markditsworth/Solar/README.md

# Solar

#### 300 Watt Solar Bank with Battery Storage
