markditsworth/Solar/inverter/Sims/boost.asc

C1: polcap; 3300µ; V=63 Irms=2.27 Rser=0.0218909 Lser=34.4602n mfg="Würth Elektronik" pn="861140784012 WCAP-AI3H 25x35" type="Al electrolytic"
C2: cap; 2.3n; V=100
C3: cap; 0.1
C5: polcap; 3300µ; V=63 Irms=2.27 Rser=0.0218909 Lser=34.4602n mfg="Würth Elektronik" pn="861140784012 WCAP-AI3H 25x35" type="Al electrolytic"
D1: schottky; MBRS1100
L1: ind; 1000n; Ipk=63 Rser=0.0016 Rpar=94.2 Cpar=0 mfg="Coilcraft" pn="CU8838"
M1: nmos; BSC016N03MS
R1: res; 1; pwr=500
R2: res; 580K; pwr=500
R3: res; 100K; pwr=500
R4: res; 6; pwr=500
R5: res; 2600; pwr=0.25
R6: res; 0.0075; pwr=500
U1: LT1241
V1: voltage; 12
V2: voltage; 15
Named nets: 0, Out, bridge, GS, 15V
.tran 0.01u 1m 0
