markditsworth/Solar/charger/charger.kicad_pcb

## KiCad design charger/charger.kicad_pcb (2020-12-03)

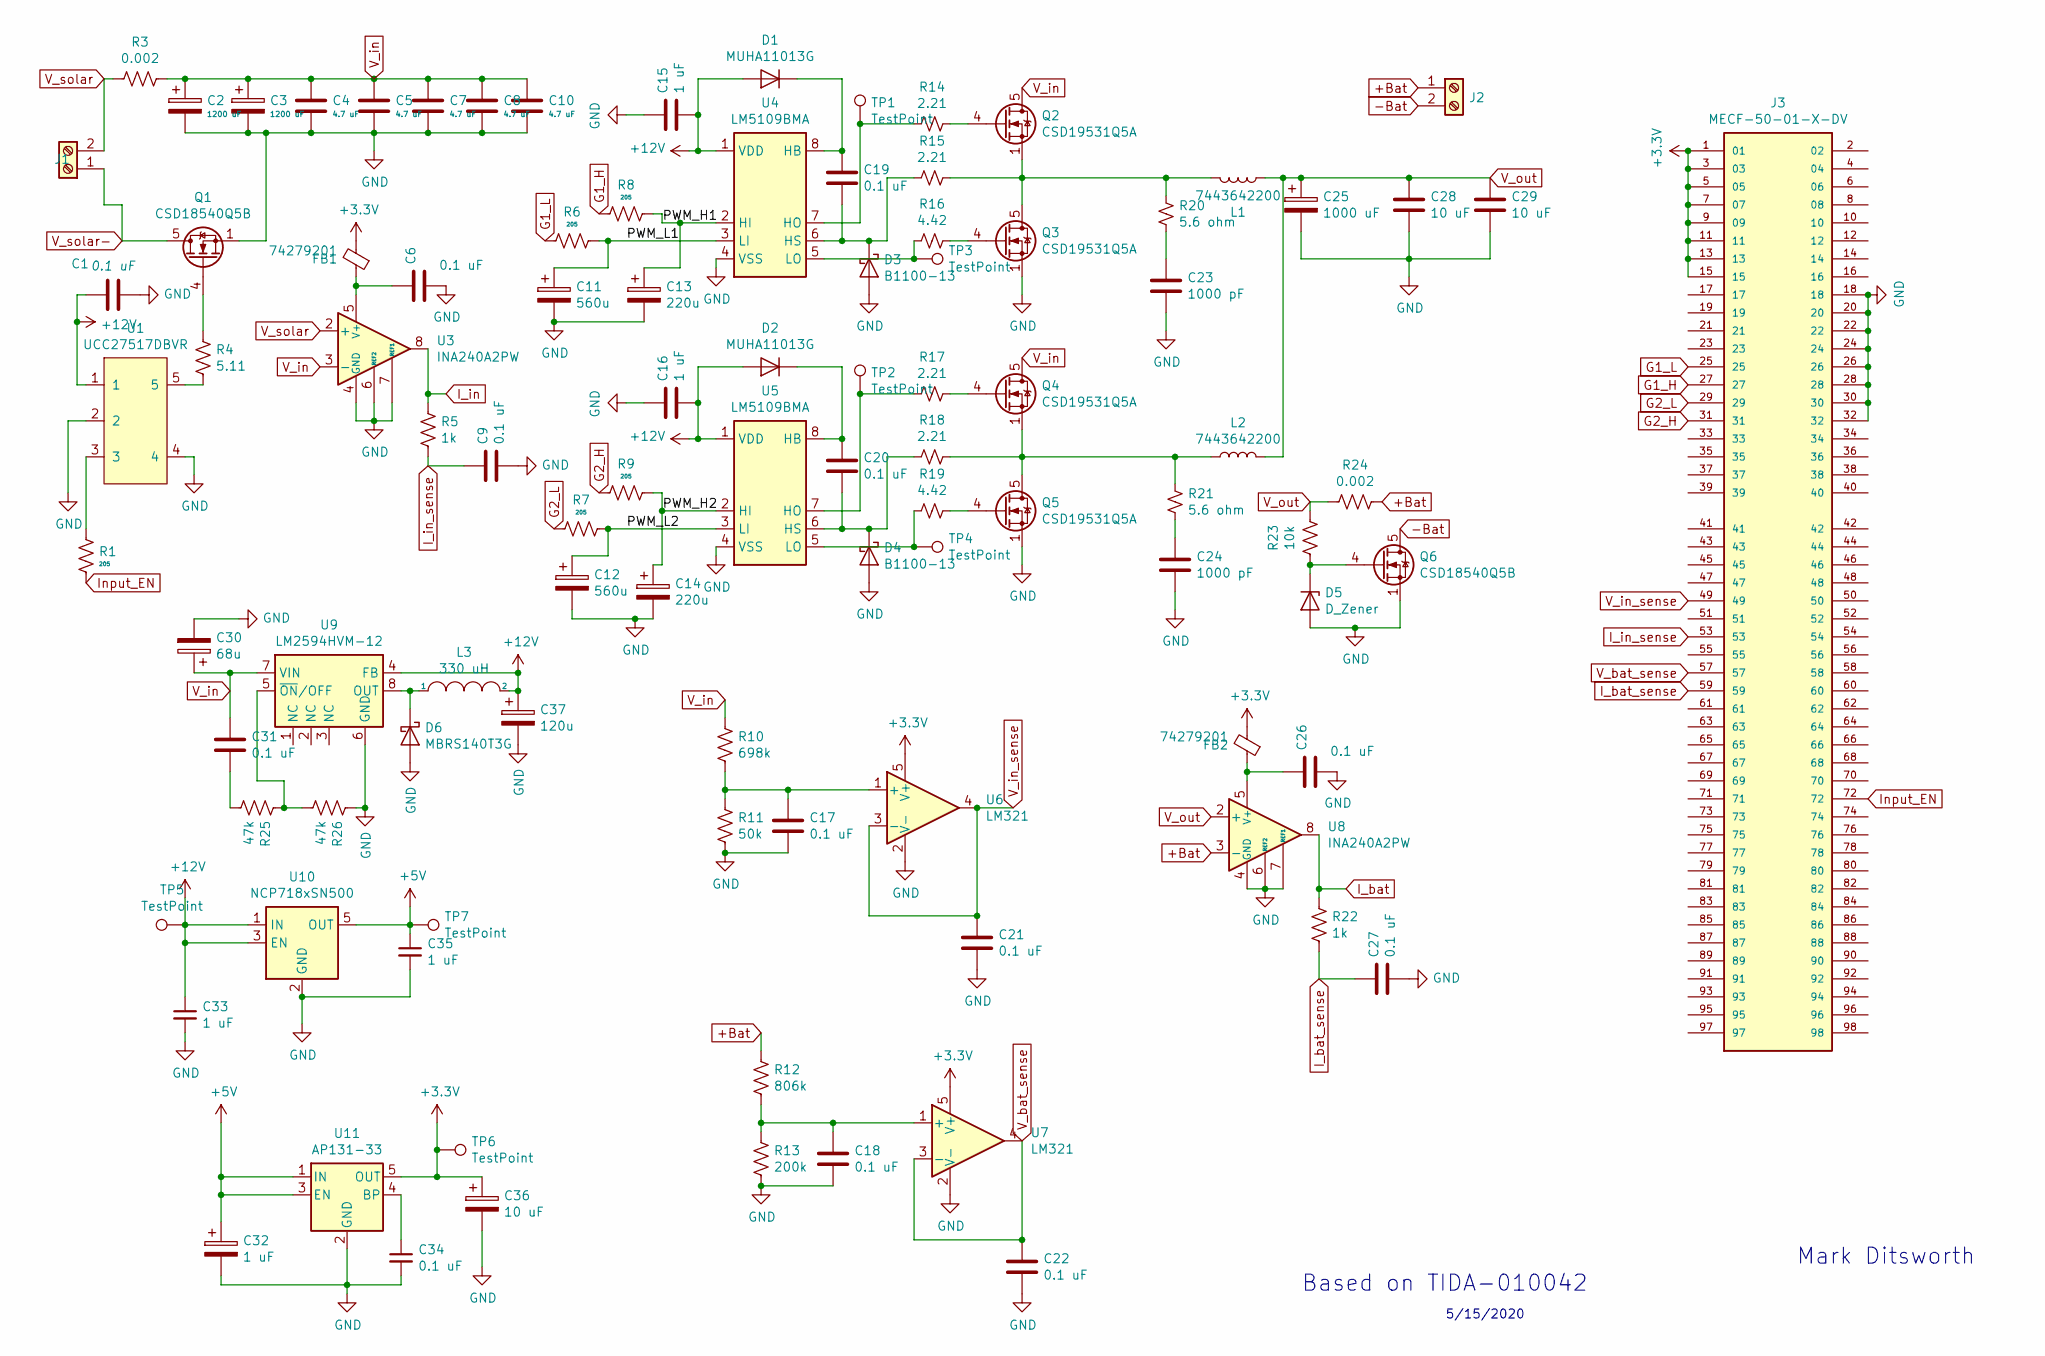
[picture p1: schematic charger.sch]

Parts:
C1, C6, C9, C17, C18, C19, C20, C21, C22, C26, C27, C31, C34: 0.1 uF; C_1206_3216Metric
C2, C3: 1200 uF; CP_Radial_D25.0mm_P10.00mm_SnapIn
C4, C5, C7, C8, C10: 4.7 uF; C_1206_3216Metric
C11, C12: 560u; C_Elec_8x10.2
C13, C14: 220u; C_Elec_6.3x7.7
C15, C16, C33, C35: 1 uF; C_1206_3216Metric
C23, C24: 1000 pF; C_1206_3216Metric
C25: 1000 uF; CP_Radial_D30.0mm_P10.00mm_SnapIn
C28, C29: 10 uF; C_1206_3216Metric
C30: 68u; C_Elec_8x10.2
C32: 1 uF; CP_Radial_D5.0mm_P2.00mm
C36: 10 uF; CP_Radial_D6.3mm_P2.50mm
C37: 120u; C_Elec_10x10.2
D1, D2: MUHA11013G; D_SMA
D3, D4: B1100-13; D_SMA
D5: D_Zener; D_SMA
D6: MBRS140T3G; D_SMB_Handsoldering
FB1, FB2: 74279201; L_0805_2012Metric
J1, J2: OSTT7020150; Phoenix_MKDS_6.35
J3: MECF-50-01-X-DV; SAMTEC_MECF-50-01-X-DV; PARTREV D
L1, L2: 7443642200; 7443642200 _Inductor
L3: 330 uH; L_Bourns_SRR1260
Q1, Q6: CSD18540Q5B; TDSON-8-1
Q2, Q3, Q4, Q5: CSD19531Q5A; TDSON-8-1
R1, R6, R7, R8, R9: 205; R_1206_3216Metric
R3, R24: 0.002; R_2512_6332Metric
R4: 5.11; R_1206_3216Metric
R5, R22: 1k; R_1206_3216Metric
R10: 698k; R_1206_3216Metric
R11: 50k; R_1206_3216Metric
R12: 806k; R_1206_3216Metric
R13: 200k; R_1206_3216Metric
R14, R15, R17, R18: 2.21; R_1206_3216Metric
R16, R19: 4.42; R_1206_3216Metric
R20, R21: 5.6 ohm; R_1206_3216Metric
R23: 10k; R_1206_3216Metric
R25, R26: 47k; R_1206_3216Metric
TP1, TP2, TP3, TP4, TP5, TP6, TP7: TestPoint; Pin_D1.4mm_L8.5mm_W2.8mm_FlatFork
U1: UCC27517DBVR; SOT-23-5
U3, U8: INA240A2PW; SOIC-8_3.9x4.9mm_P1.27mm
U4, U5: LM5109BMA; SOIC-8_3.9x4.9mm_P1.27mm
U6, U7: LM321; SOT-23-5
U9: LM2594HVM-12; SOIC-8_3.9x4.9mm_P1.27mm
U10: NCP718xSN500; SOT-23-5
U11: AP131-33; SOT-23-5

Connections:
+3V3: C36.1, FB1.2, FB2.2, J3.1, J3.3, J3.5, J3.7, J3.9, J3.11, J3.13, J3.15, TP6.1, U6.5 (V+), U7.5 (V+), U11.5 (OUT)
+5V: C32.1, C35.1, TP7.1, U10.5 (OUT), U11.1 (IN), U11.3 (EN)
+12V: C1.2, C15.2, C16.2, C33.1, C37.1, D1.2 (A), D2.2 (A), L3.2, TP5.1, U1.1, U4.1 (VDD), U5.1 (VDD), U9.4 (FB), U10.1 (IN), U10.3 (EN)
+Bat: J2.1, R12.1, R24.1, U8.3 (-)
-Bat: J2.2, Q6.5 (D)
/PWM_H1: C13.1, R8.1, U4.2 (HI)
/PWM_H2: C14.1, R9.1, U5.2 (HI)
/PWM_L1: C11.1, R6.1, U4.3 (LI)
/PWM_L2: C12.1, R7.1, U5.3 (LI)
G1_H: J3.27, R8.2
G1_L: J3.25, R6.2
G2_H: J3.31, R9.2
G2_L: J3.29, R7.2
GND: C1.1, C2.2, C3.2, C4.2, C5.2, C6.2, C7.2, C8.2, C9.2, C10.2, C11.2, C12.2, C13.2, C14.2, C15.1, C16.1, C17.2, C18.2, C21.2, C22.2, C23.2, C24.2, C25.2, C26.2, C27.2, C28.2, C29.2, C30.2, C32.2, C33.2, C34.2, C35.2, C36.2, C37.2, D3.2 (A), D4.2 (A), D5.2 (A), D6.2 (A), J3.18, J3.20, J3.22, J3.24, J3.26, J3.28, J3.30, J3.32, Q1.1 (S), Q1.2 (S), Q1.3 (S), Q3.1 (S), Q3.2 (S), Q3.3 (S), Q5.1 (S), Q5.2 (S), Q5.3 (S), Q6.1 (S), Q6.2 (S), Q6.3 (S), R11.2, R13.2, R26.1, U1.2, U1.4, U3.1 (GND), U3.4 (GND), U3.6 (REF2), U3.7 (REF1), U4.4 (VSS), U5.4 (VSS), U6.2 (V-), U7.2 (V-), U8.1 (GND), U8.4 (GND), U8.6 (REF2), U8.7 (REF1), U9.6 (GND), U10.2 (GND), U11.2 (GND)
I_bat: R22.1, U8.8
I_bat_sense: C27.1, J3.59, R22.2
I_in: R5.1, U3.8
I_in_sense: C9.1, J3.53, R5.2
Input_EN: J3.72, R1.1
unnamed: C6.1, FB1.1, U3.5 (V+)
unnamed: C17.1, R10.2, R11.1, U6.1 (+)
unnamed: C18.1, R12.2, R13.1, U7.1 (+)
unnamed: C19.1, D1.1 (K), U4.8 (HB)
unnamed: C19.2, D3.1 (K), R15.2, U4.6 (HS)
unnamed: C20.1, D2.1 (K), U5.8 (HB)
unnamed: C20.2, D4.1 (K), R18.2, U5.6 (HS)
unnamed: C23.1, R20.2
unnamed: C24.1, R21.2
unnamed: C26.1, FB2.1, U8.5 (V+)
unnamed: C31.2, R25.2
unnamed: C34.1, U11.4 (BP)
unnamed: D5.1 (K), Q6.4 (G), R23.2
unnamed: D6.1 (K), L3.1, U9.8 (OUT)
unnamed: L1.2, Q2.1 (S), Q2.2 (S), Q2.3 (S), Q3.5 (D), R15.1, R20.1
unnamed: L2.1, Q4.1 (S), Q4.2 (S), Q4.3 (S), Q5.5 (D), R18.1, R21.1
unnamed: Q1.4 (G), R4.1
unnamed: Q2.4 (G), R14.1
unnamed: Q3.4 (G), R16.1
unnamed: Q4.4 (G), R17.1
unnamed: Q5.4 (G), R19.1
unnamed: R1.2, U1.3
unnamed: R4.2, U1.5
unnamed: R14.2, TP1.1, U4.7 (HO)
unnamed: R16.2, TP3.1, U4.5 (LO)
unnamed: R17.2, TP2.1, U5.7 (HO)
unnamed: R19.2, TP4.1, U5.5 (LO)
unnamed: R25.1, R26.2, U9.5 (~ON~/OFF)
V_bat_sense: C22.1, J3.57, U7.3 (-), U7.4
V_in: C2.1, C3.1, C4.1, C5.1, C7.1, C8.1, C10.1, C30.1, C31.1, Q2.5 (D), Q4.5 (D), R3.1, R10.1, U3.3 (-), U9.7 (VIN)
V_in_sense: C21.1, J3.49, U6.3 (-), U6.4
V_out: C25.1, C28.1, C29.1, L1.1, L2.2, R23.1, R24.2, U8.2 (+)
V_solar: J1.2, R3.2, U3.2 (+)
V_solar-: J1.1, Q1.5 (D)

Notes on the sheet:
Mark Ditsworth
Based on TIDA-010042
5/15/2020

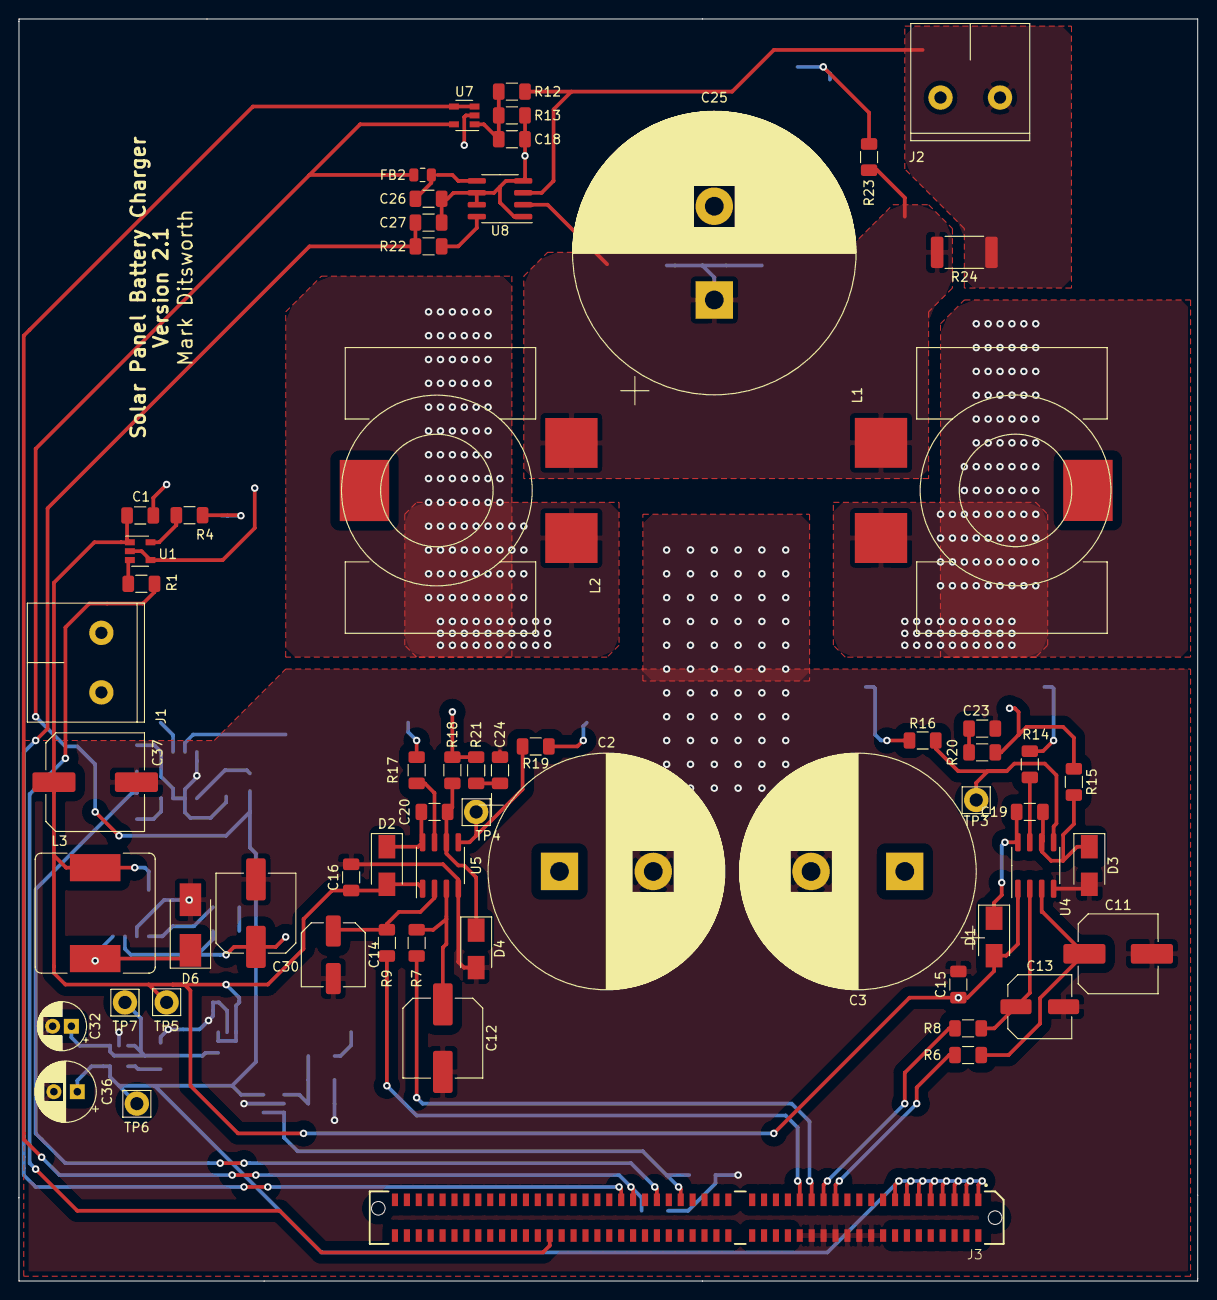
[picture p2: board charger.kicad_pcb from above]

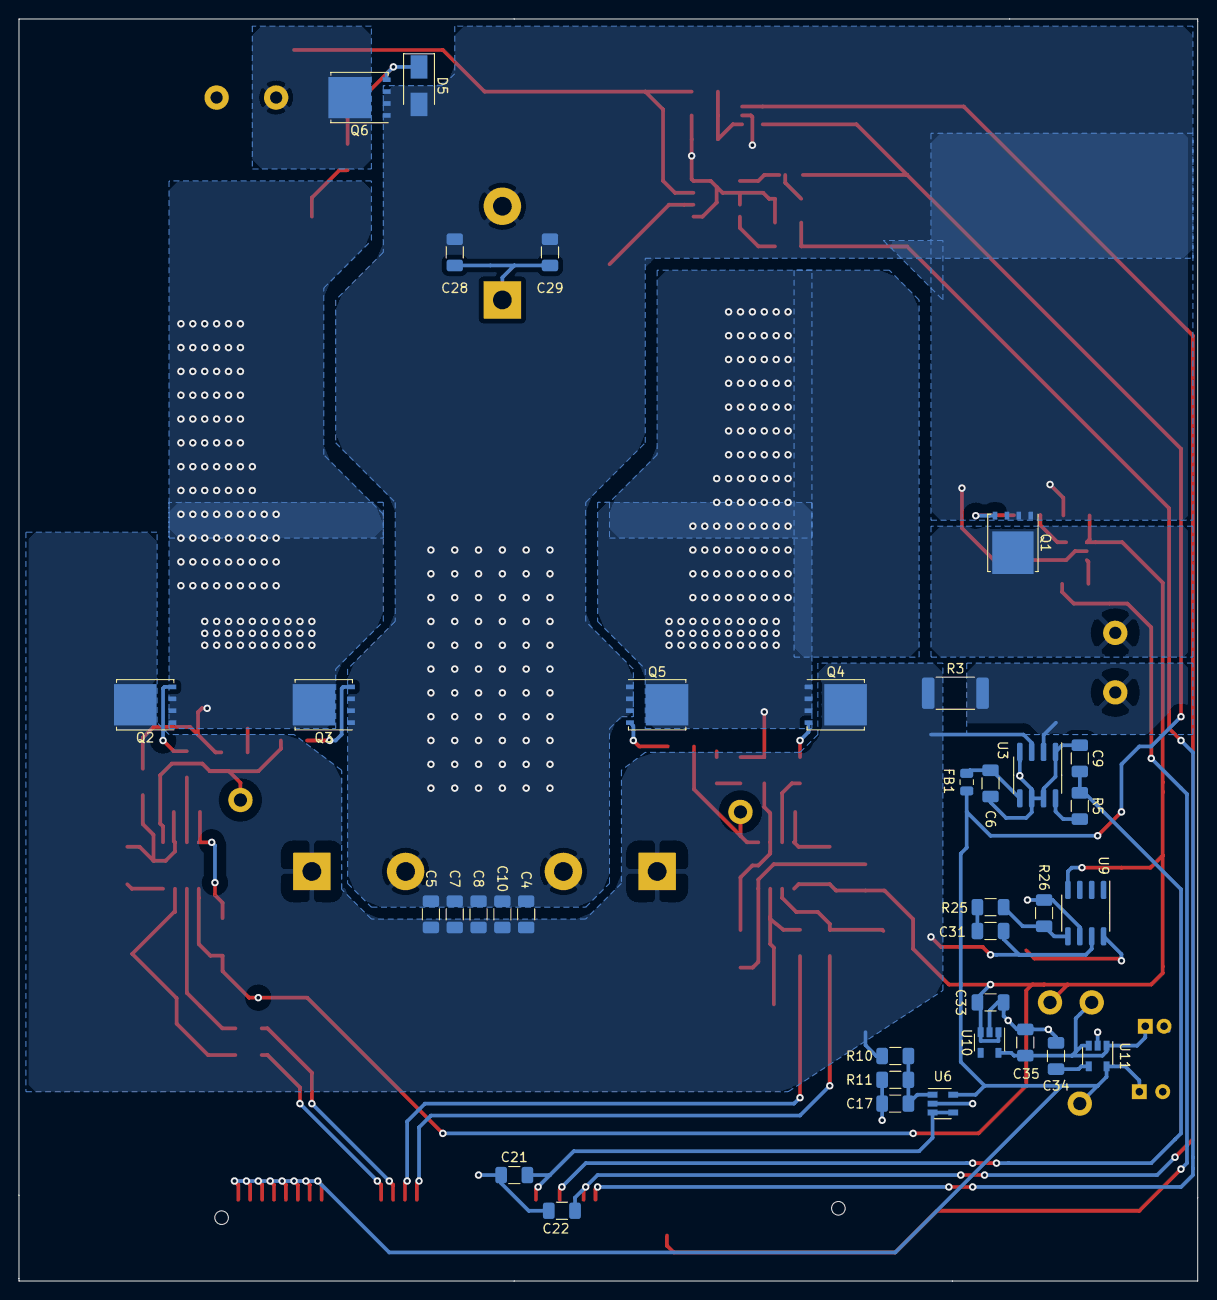
[picture p3: board charger.kicad_pcb from below]

Board: 2 copper layers, 125.7 x 134.6 mm, 97 parts (35 on the bottom side), 53 nets.
