markditsworth/Solar/code/inverter_mppt/printf.h

/*
 * printf.h
 *
 *  Created on: Dec 4, 2020
 *      Author: Sam Lewis https://github.com/samvrlewis/MSP432-printf/blob/master/printf.h
 */

#ifndef PRINTF_H_
#define PRINTF_H_

void printf(uint32_t moduleInstance, char *, ...);

#endif /* PRINTF_H_ */
