markditsworth/Solar/(commit log)

2020-05-12 add charger project
    [charger.kicad_pcb, charger.sch]
2020-05-12 added aux power schem
    [charger.sch]
2020-05-13 add power circuit
    [charger.sch]
2020-05-13 added connectors
    [charger.sch]
2020-05-14 add ckt enable/disable
    [charger.sch]
2020-05-15 add voltage dividers
    [charger.sch]
2020-05-16 begin with footprints
    [charger.sch]
2020-10-26 add footprints
    [charger.sch]
2020-10-27 start on pcb
    [charger.sch]
2020-10-28 finished pcb
    [charger-B_Cu.gbr, charger-B_Mask.gbr, charger-B_Paste.gbr, charger-B_SilkS.gbr, charger-Edge_Cuts.gbr, charger-F_Cu.gbr, charger-F_Mask.gbr, charger-F_Paste.gbr]
2020-12-03 charger pcb v2
    [charger-B_Cu.gbr, charger-B_Mask.gbr, charger-B_Paste.gbr, charger-B_SilkS.gbr, charger-Edge_Cuts.gbr, charger-F_Cu.gbr, charger-F_Mask.gbr, charger-F_Paste.gbr]
2020-12-05 update gitignore
    [charger.sch]
2020-12-05 update printf
2020-12-06 ADC + UART tx minimal function working
